ginomcfino/esp32-dev-board/docs/checks/README.md

# Check Notes

Verified with KiCad 10.0.5 on 2026-10-28, using the saved project rules and including schematic-to-board comparison. Error, warning, and exclusion severities were included. The reports retain the list of checks disabled in the project settings.

| Check | Findings |
| --- | ---: |
| Schematic electrical rules (ERC) | 0 |
| PCB design rules (DRC) | 0 |
| Unconnected PCB items | 0 |
| Schematic-to-board consistency | 0 |

Reports: [ERC](erc.json) and [DRC / schematic comparison](drc.json).

A [separate dimensional check](drc-dimension-probe.json) also passed with explicit minimum clearance of 0.15 mm, track width of 0.20 mm, and connection width of 0.10 mm. The packaged project retains its supplied settings.

Circuit review identified open items in Q1/Q2 power switching and D4 LED pin mapping and supply selection. Findings and next actions are documented in the [engineering review](../engineering-review.md).

The schematic PDF, component list, PCB views, and 3D render were generated from the packaged revision. All symbol and footprint references resolve in the standard KiCad 10 libraries. Packaging standardized filenames and the 3D-model library variable; circuit connectivity, routing, and rule settings were retained.

The saved reports are unchanged by the documentation cleanup. The [file manifest](files-sha256.json) records the current package contents.
