ginomcfino/esp32-dev-board/docs/images/schematic-overview.png

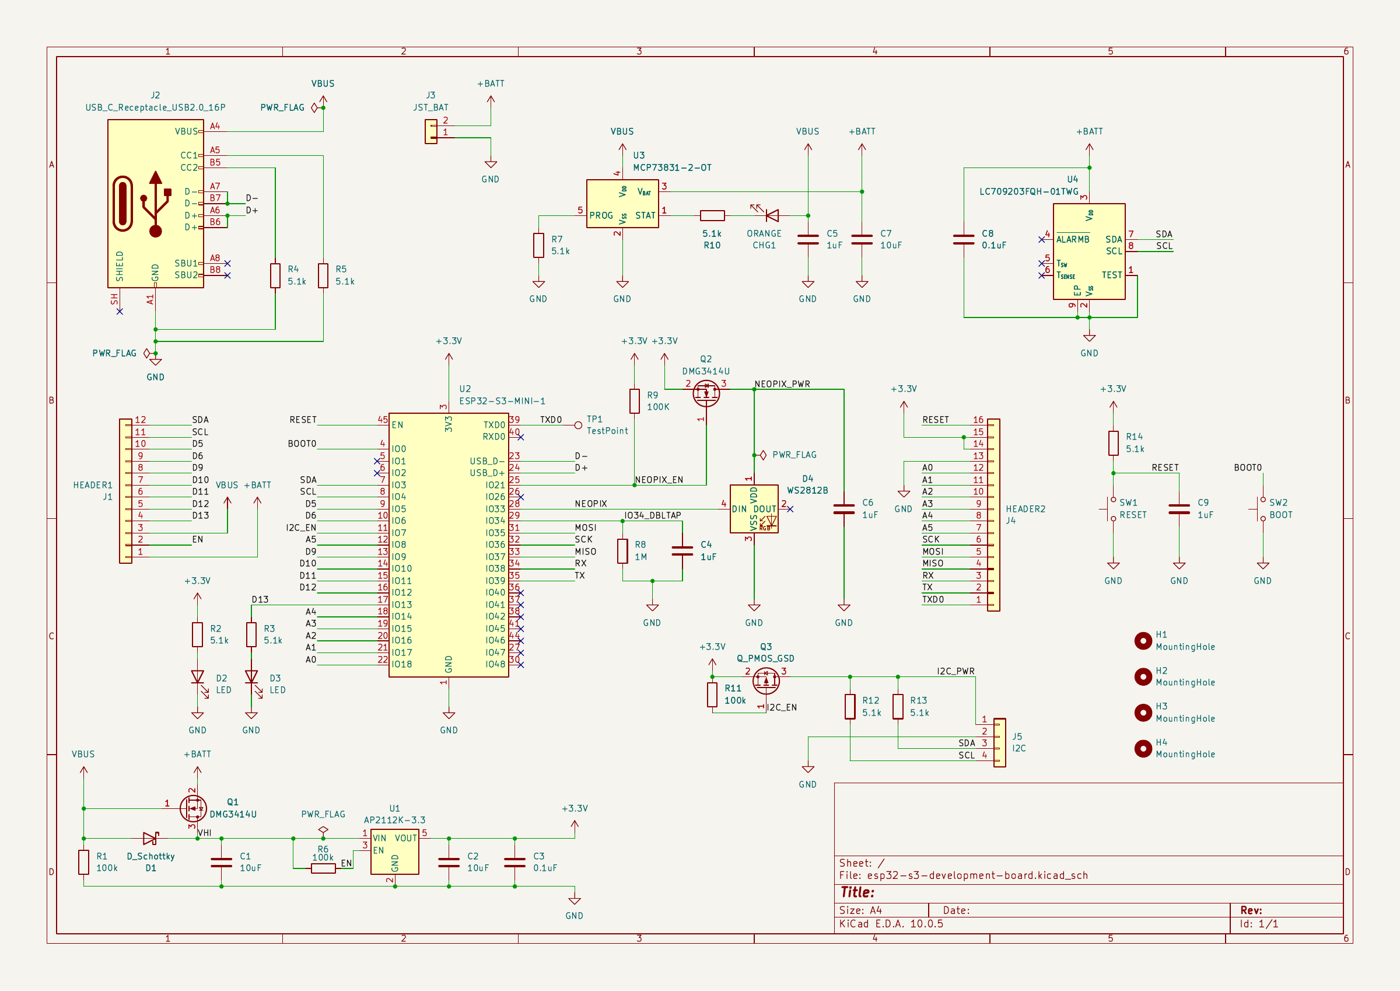
docs/images/schematic-overview.png
