ginomcfino/esp32-dev-board/exports/bom.csv

Refs | Value | Footprint | Qty | DNP
C1 | 10uF | Capacitor_SMD:C_0603_1608Metric | 1
C2 | 10uF | Capacitor_SMD:C_0603_1608Metric | 1
C3 | 0.1uF | Capacitor_SMD:C_0402_1005Metric | 1
C4 | 1uF | Capacitor_SMD:C_0402_1005Metric | 1
C5 | 1uF | Capacitor_SMD:C_0402_1005Metric | 1
C6 | 1uF | Capacitor_SMD:C_0402_1005Metric | 1
C7 | 10uF | Capacitor_SMD:C_0603_1608Metric | 1
C8 | 0.1uF | Capacitor_SMD:C_0402_1005Metric | 1
C9 | 1uF | Capacitor_SMD:C_0402_1005Metric | 1
CHG1 | ORANGE | LED_SMD:LED_0603_1608Metric | 1
D1 | D_Schottky | Diode_SMD:D_SOD-323 | 1
D2 | LED | LED_SMD:LED_0603_1608Metric | 1
D3 | LED | LED_SMD:LED_0603_1608Metric | 1
D4 | WS2812B | LED_SMD:LED_WS2812B-2020_PLCC4_2.0x2.0mm | 1
J1 | HEADER1 | Connector_PinHeader_2.54mm:PinHeader_1x12_P2.54mm_Vertical | 1
J2 | USB_C_Receptacle_USB2.0_16P | Connector_USB:USB_C_Receptacle_GCT_USB4105-xx-A_16P_TopMnt_Horizontal | 1
J3 | JST_BAT | Connector_JST:JST_SH_SM02B-SRSS-TB_1x02-1MP_P1.00mm_Horizontal | 1
J4 | HEADER2 | Connector_PinHeader_2.54mm:PinHeader_1x16_P2.54mm_Vertical | 1
J5 | I2C | Connector_JST:JST_SH_BM04B-SRSS-TB_1x04-1MP_P1.00mm_Vertical | 1
Q1 | DMG3414U | Package_TO_SOT_SMD:SOT-23 | 1
Q2 | DMG3414U | Package_TO_SOT_SMD:SOT-23 | 1
Q3 | Q_PMOS_GSD | Package_TO_SOT_SMD:SOT-23 | 1
R1 | 100k | Resistor_SMD:R_0402_1005Metric | 1
R2 | 5.1k | Resistor_SMD:R_0402_1005Metric | 1
R3 | 5.1k | Resistor_SMD:R_0402_1005Metric | 1
R4 | 5.1k | Resistor_SMD:R_0402_1005Metric | 1
R5 | 5.1k | Resistor_SMD:R_0402_1005Metric | 1
R6 | 100k | Resistor_SMD:R_0402_1005Metric | 1
R7 | 5.1k | Resistor_SMD:R_0402_1005Metric | 1
R8 | 1M | Resistor_SMD:R_0402_1005Metric | 1
R9 | 100K | Resistor_SMD:R_0402_1005Metric | 1
R10 | 5.1k | Resistor_SMD:R_0402_1005Metric | 1
R11 | 100k | Resistor_SMD:R_0402_1005Metric | 1
R12 | 5.1k | Resistor_SMD:R_0402_1005Metric | 1
R13 | 5.1k | Resistor_SMD:R_0402_1005Metric | 1
R14 | 5.1k | Resistor_SMD:R_0402_1005Metric | 1
SW1 | RESET | Button_Switch_SMD:SW_SPST_PTS810 | 1
SW2 | BOOT | Button_Switch_SMD:SW_SPST_PTS810 | 1
TP1 | TestPoint | TestPoint:TestPoint_Pad_D1.0mm | 1
U1 | AP2112K-3.3 | Package_TO_SOT_SMD:SOT-23-5 | 1
U2 | ESP32-S3-MINI-1 | RF_Module:ESP32-S2-MINI-1 | 1
U3 | MCP73831-2-OT | Package_TO_SOT_SMD:SOT-23-5 | 1
U4 | LC709203FQH-01TWG | Package_DFN_QFN:WDFN-8-1EP_4x3mm_P0.65mm_EP2.4x1.8mm | 1
