ginomcfino/esp32-dev-board/exports/schematic.pdf

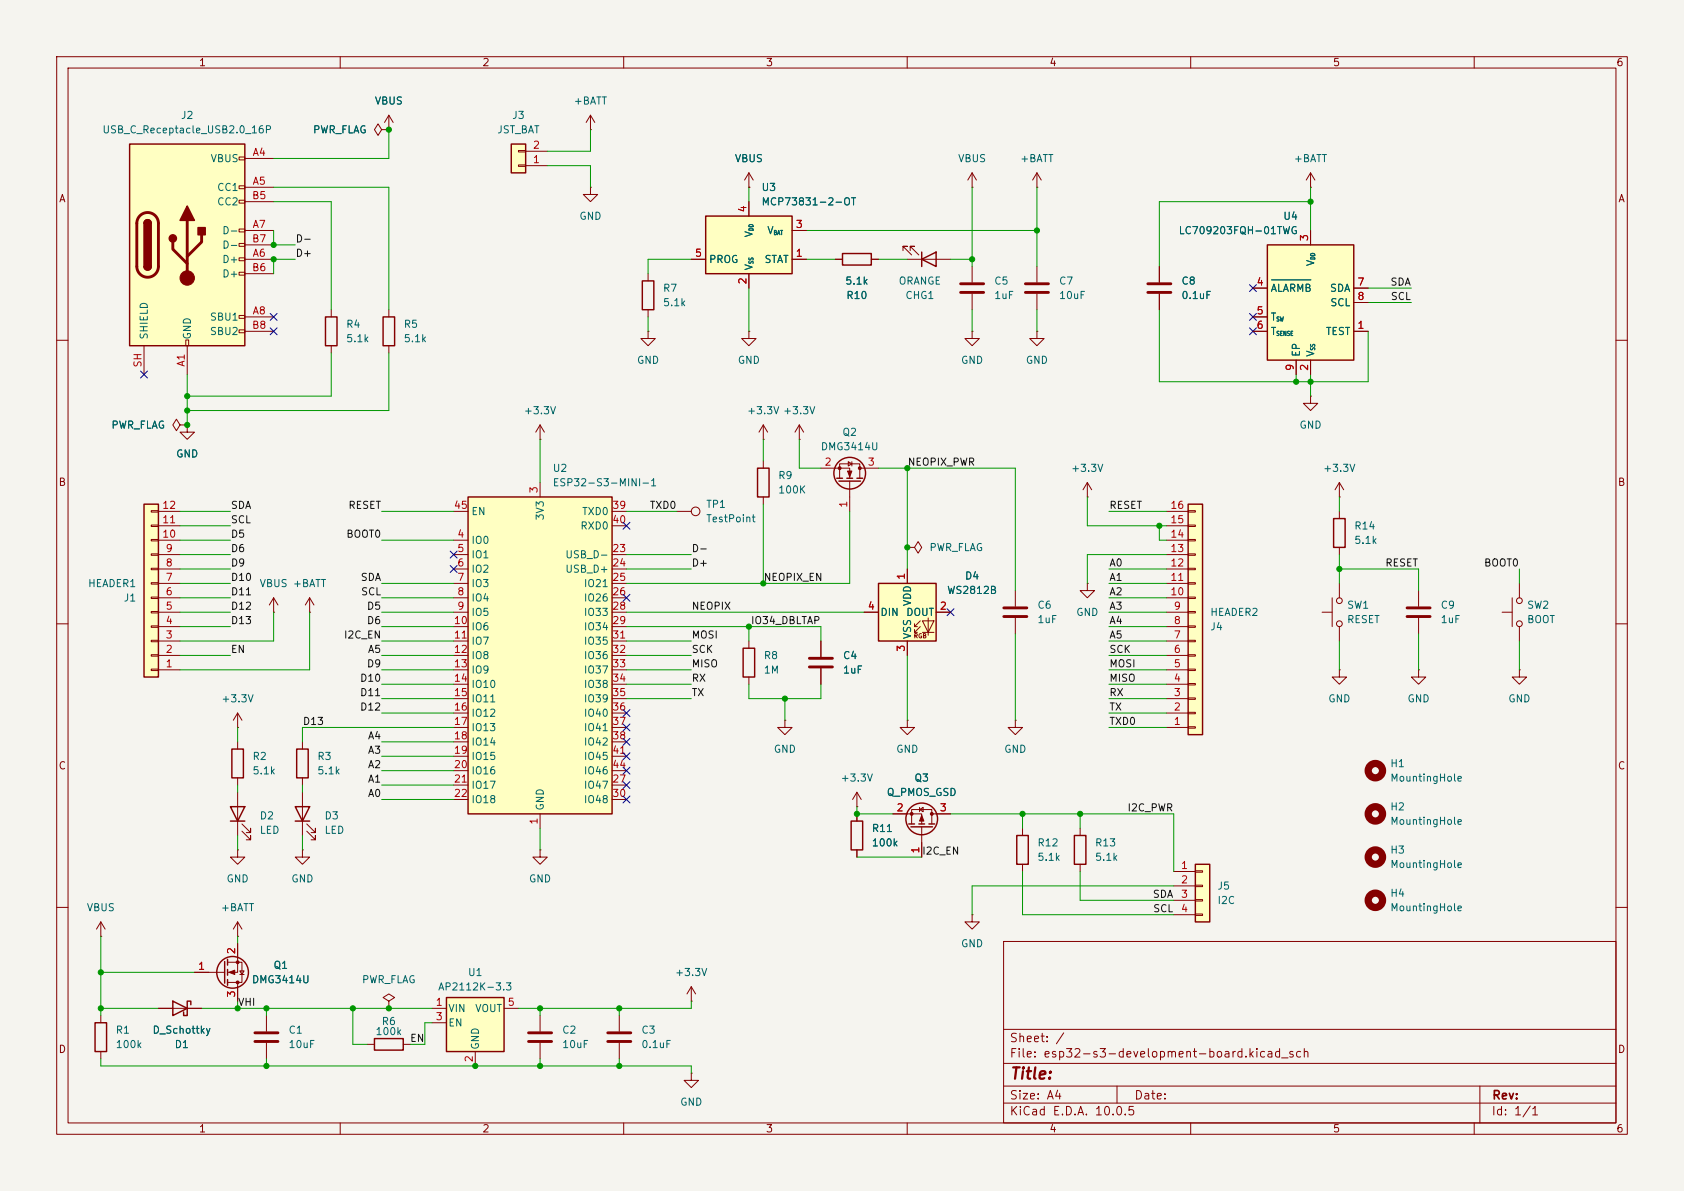
[picture p3: page 1]

Size: A4 | Rev:
KiCad E.D.A. 10.0.5 | Id: 1/1
