ginomcfino/esp32-dev-board/hardware/esp32-s3-development-board.kicad_pcb

## KiCad design hardware/esp32-s3-development-board.kicad_pcb (2026-10-28)

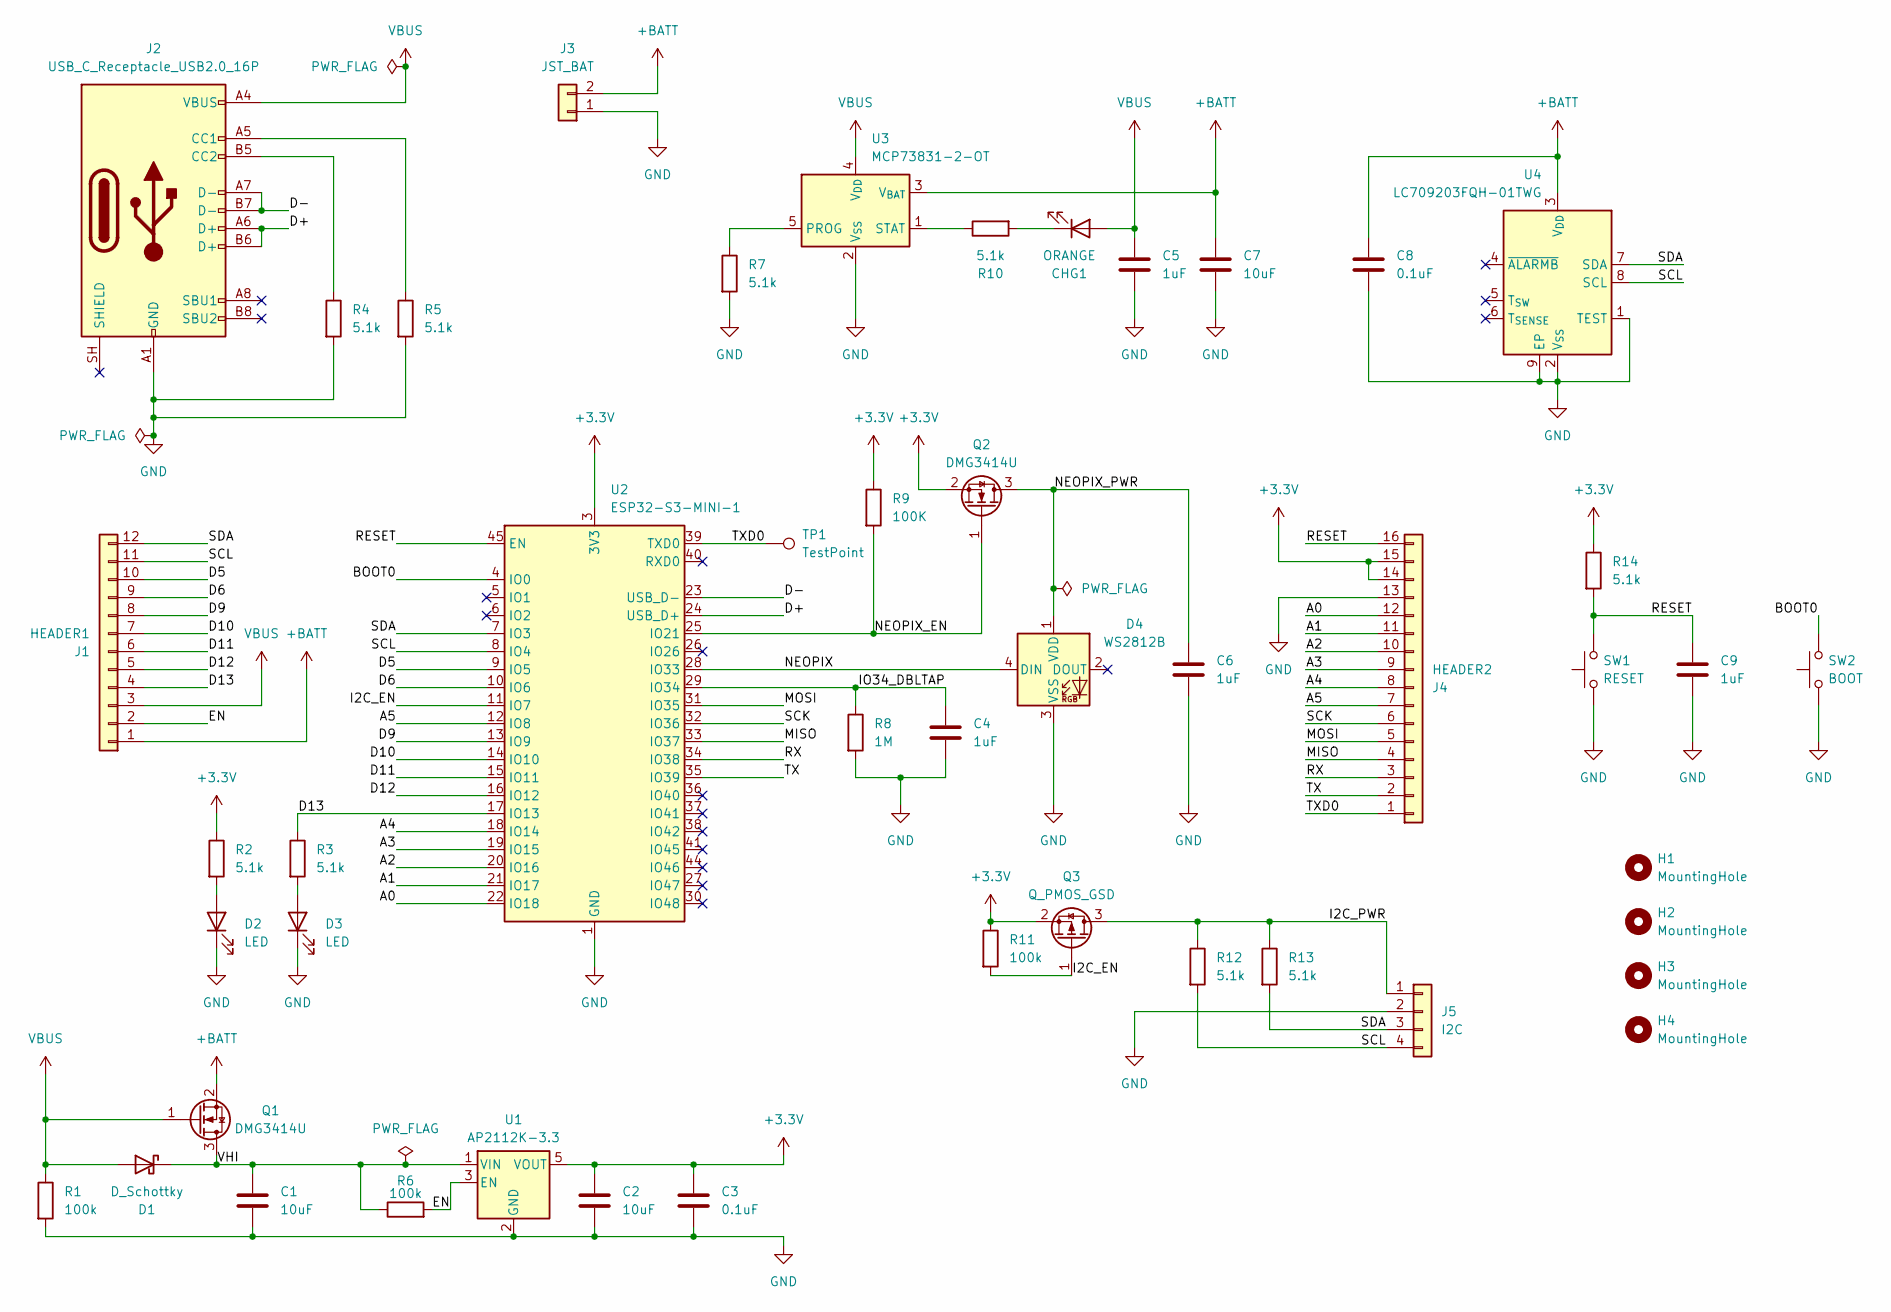
[picture p4: schematic esp32-s3-development-board.kicad_sch]

Parts:
C1, C2, C7: 10uF; C_0603_1608Metric
C3, C8: 0.1uF; C_0402_1005Metric
C4, C5, C6, C9: 1uF; C_0402_1005Metric
CHG1: ORANGE; LED_0603_1608Metric
D1: D_Schottky; D_SOD-323
D2, D3: LED; LED_0603_1608Metric
D4: WS2812B; LED_WS2812B-2020_PLCC4_2.0x2.0mm
H1, H2: MountingHole; MountingHole_2.2mm_M2
H3, H4: MountingHole; MountingHole_2.2mm_M2_Pad
J1: HEADER1; PinHeader_1x12_P2.54mm_Vertical
J2: USB_C_Receptacle_USB2.0_16P; USB_C_Receptacle_GCT_USB4105-xx-A_16P_TopMnt_Horizontal
J3: JST_BAT; JST_SH_SM02B-SRSS-TB_1x02-1MP_P1.00mm_Horizontal
J4: HEADER2; PinHeader_1x16_P2.54mm_Vertical
J5: I2C; JST_SH_BM04B-SRSS-TB_1x04-1MP_P1.00mm_Vertical
Q1, Q2: DMG3414U; SOT-23
Q3: Q_PMOS_GSD; SOT-23
R1, R6, R11: 100k; R_0402_1005Metric
R2, R3, R4, R5, R7, R10, R12, R13, R14: 5.1k; R_0402_1005Metric
R8: 1M; R_0402_1005Metric
R9: 100K; R_0402_1005Metric
SW1: RESET; SW_SPST_PTS810
SW2: BOOT; SW_SPST_PTS810
TP1: TestPoint; TestPoint_Pad_D1.0mm
U1: AP2112K-3.3; SOT-23-5
U2: ESP32-S3-MINI-1; ESP32-S2-MINI-1
U3: MCP73831-2-OT; SOT-23-5
U4: LC709203FQH-01TWG; WDFN-8-1EP_4x3mm_P0.65mm_EP2.4x1.8mm

Connections:
+3.3V: C2.1, C3.1, J4.14, J4.15, Q2.2 (S), Q3.2 (S), R2.1, R9.1, R11.1, R14.1, U1.5 (VOUT), U2.3 (3V3)
+BATT: C7.1, C8.1, J1.1, J3.2, Q1.2 (S), U3.3 (V_{BAT}), U4.3 (V_{DD})
/A0: J4.12, U2.22 (IO18)
/A1: J4.11, U2.21 (IO17)
/A2: J4.10, U2.20 (IO16)
/A3: J4.9, U2.19 (IO15)
/A4: J4.8, U2.18 (IO14)
/A5: J4.7, U2.12 (IO8)
/BOOT0: SW2.2, U2.4 (IO0)
/D5: J1.10, U2.9 (IO5)
/D6: J1.9, U2.10 (IO6)
/D9: J1.8, U2.13 (IO9)
/D10: J1.7, U2.14 (IO10)
/D11: J1.6, U2.15 (IO11)
/D12: J1.5, U2.16 (IO12)
/D13: J1.4, R3.1, U2.17 (IO13)
/D+: J2.A6 (D+), J2.B6 (D+), U2.24 (USB_D+)
/D-: J2.A7 (D-), J2.B7 (D-), U2.23 (USB_D-)
/EN: J1.2, R6.2, U1.3 (EN)
/I2C_EN: Q3.1 (G), R11.2, U2.11 (IO7)
/I2C_PWR: J5.1, Q3.3 (D), R12.1, R13.1
/IO34_DBLTAP: C4.1, R8.1, U2.29 (IO34)
/MISO: J4.4, U2.33 (IO37)
/MOSI: J4.5, U2.31 (IO35)
/NEOPIX: D4.4 (DIN), U2.28 (IO33)
/NEOPIX_EN: Q2.1 (G), R9.2, U2.25 (IO21)
/NEOPIX_PWR: C6.1, D4.1 (VDD), Q2.3 (D)
/RESET: C9.1, J4.16, R14.2, SW1.2, U2.45 (EN)
/RX: J4.3, U2.34 (IO38)
/SCK: J4.6, U2.32 (IO36)
/SCL: J1.11, J5.4, R12.2, U2.8 (IO4), U4.8 (SCL)
/SDA: J1.12, J5.3, R13.2, U2.7 (IO3), U4.7 (SDA)
/TX: J4.2, U2.35 (IO39)
/TXD0: J4.1, TP1.1 (1_1), U2.39 (TXD0)
/VHI: C1.1, D1.1 (K), Q1.3 (D), R6.1, U1.1 (VIN)
GND: C1.2, C2.2, C3.2, C4.2, C5.2, C6.2, C7.2, C8.2, C9.2, D2.1 (K), D3.1 (K), D4.3 (VSS), J2.A1 (GND), J2.A12 (GND), J2.B1 (GND), J2.B12 (GND), J3.1, J4.13, J5.2, R1.2, R4.2, R5.2, R7.2, R8.2, SW1.1, SW2.1, U1.2 (GND), U2.1 (GND), U2.2 (GND), U2.42 (GND), U2.43 (GND), U2.46 (GND), U2.47 (GND), U2.48 (GND), U2.49 (GND), U2.50 (GND), U2.51 (GND), U2.52 (GND), U2.53 (GND), U2.54 (GND), U2.55 (GND), U2.56 (GND), U2.57 (GND), U2.58 (GND), U2.59 (GND), U2.60 (GND), U2.61 (GND), U2.62 (GND), U2.63 (GND), U2.64 (GND), U2.65 (GND), U3.2 (V_{SS}), U4.1 (TEST), U4.2 (V_{SS}), U4.9 (EP)
unnamed: CHG1.1 (K), R10.2
unnamed: D2.2 (A), R2.2
unnamed: D3.2 (A), R3.2
unnamed: J2.A5 (CC1), R5.1
unnamed: J2.B5 (CC2), R4.1
unnamed: R7.1, U3.5 (PROG)
unnamed: R10.1, U3.1 (STAT)
VBUS: C5.1, CHG1.2 (A), D1.2 (A), J1.3, J2.A4 (VBUS), J2.A9 (VBUS), J2.B4 (VBUS), J2.B9 (VBUS), Q1.1 (G), R1.1, U3.4 (V_{DD})

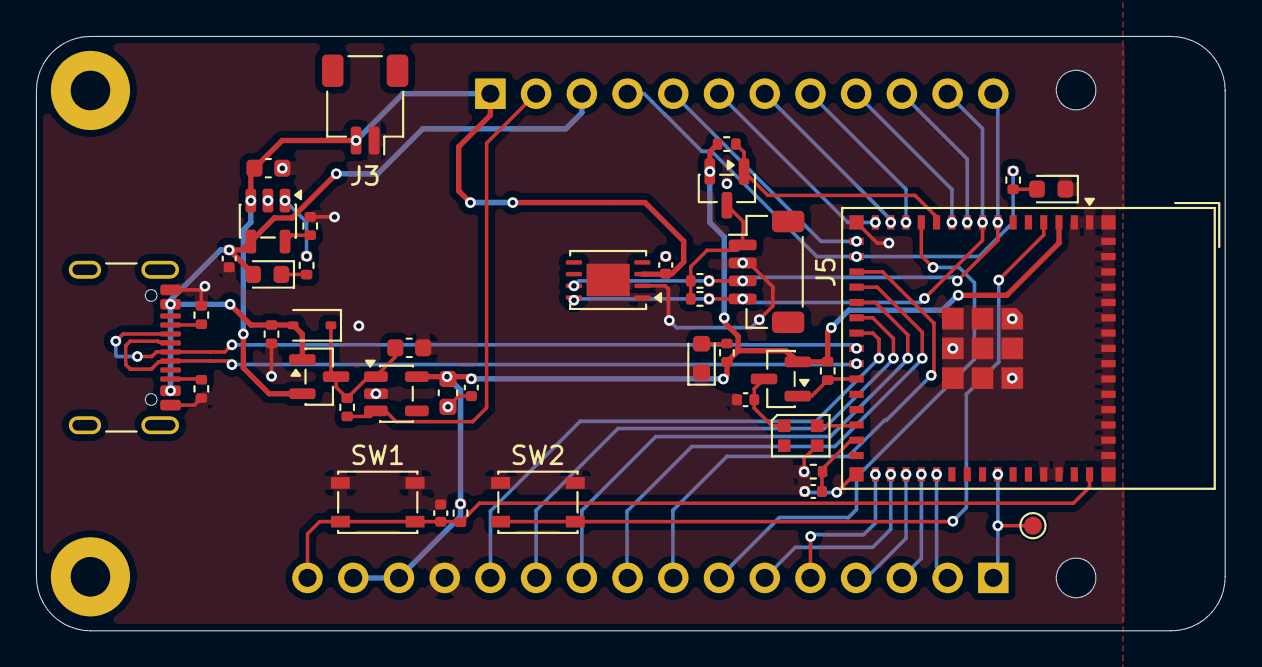
[picture p5: board esp32-s3-development-board.kicad_pcb from above]

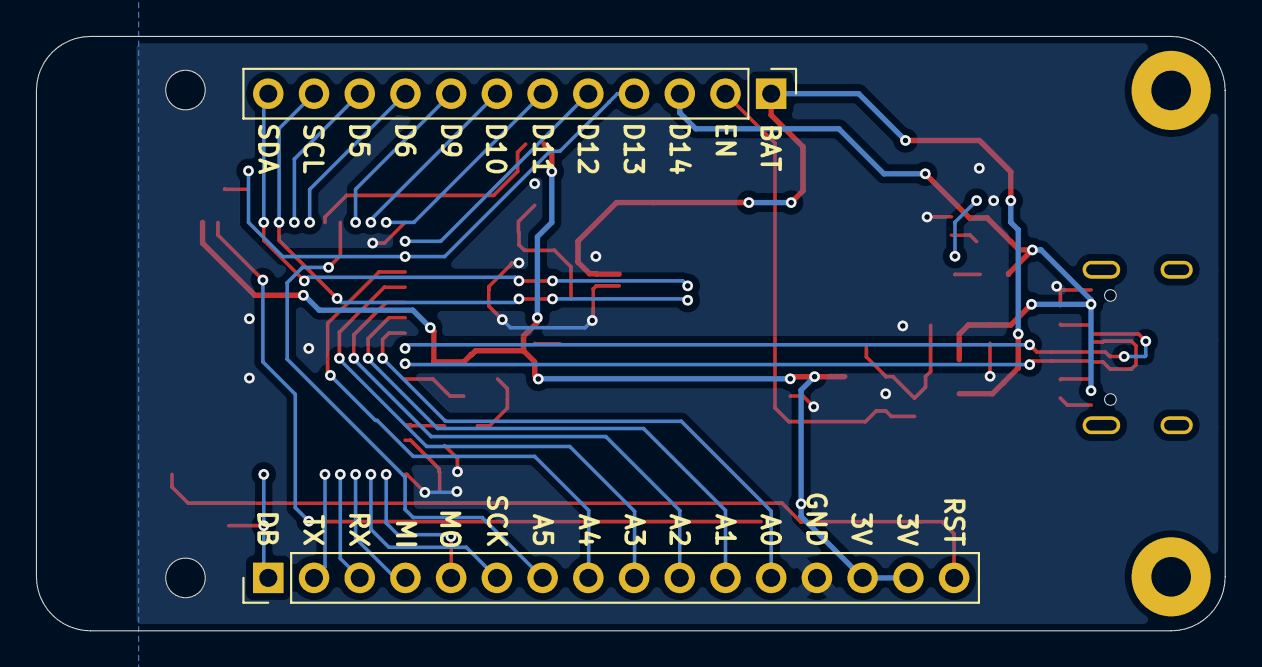
[picture p6: board esp32-s3-development-board.kicad_pcb from below]

Board: 2 copper layers, 66.0 x 33.0 mm, 47 parts (2 on the bottom side), 44 nets.
